brainsmoke/usb_null/README.md

# USB <-> USB 'null-modem' (but electrically isolated) [UNTESTED]

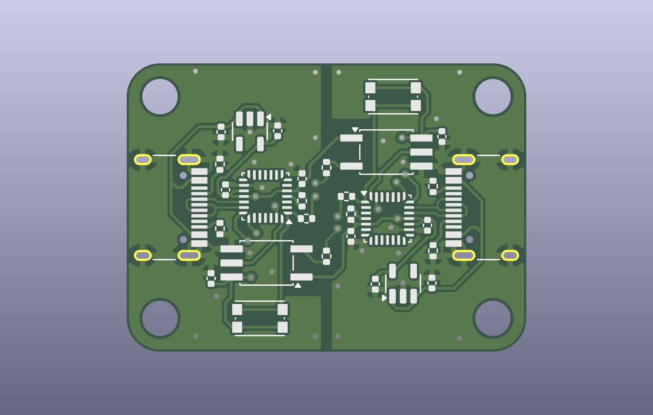
[picture p1: img/usb_null.png]


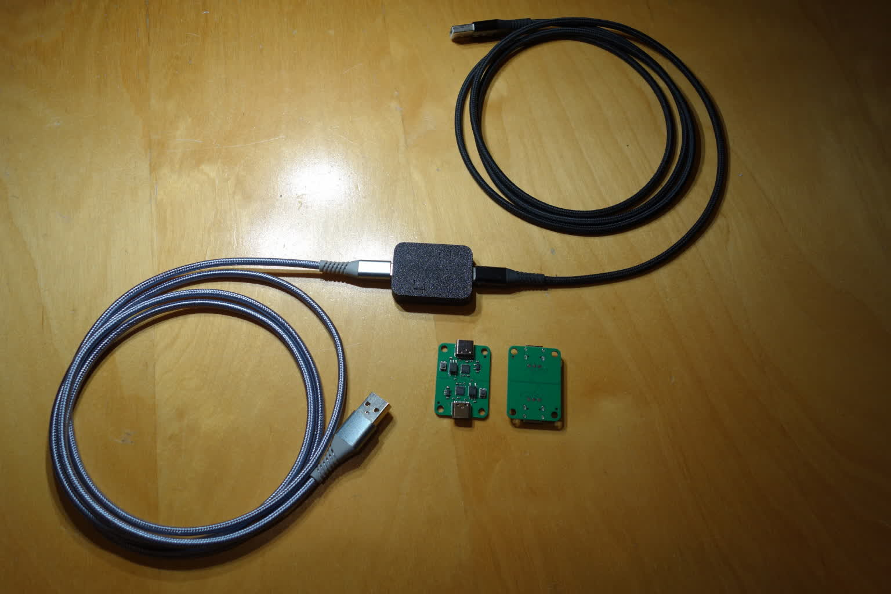
[picture p2: img/usb_null.jpg]


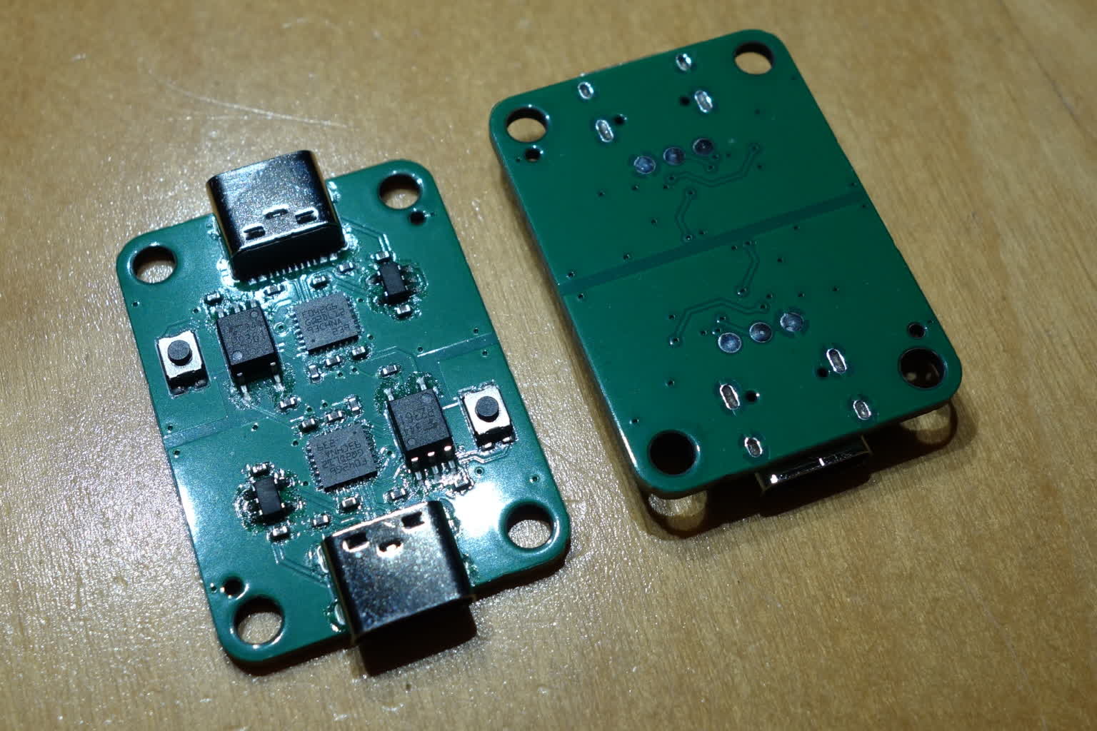
[picture p3: img/usb_null_closeup.jpg]
