brainsmoke/usb_null/build/usb_null/case.stl

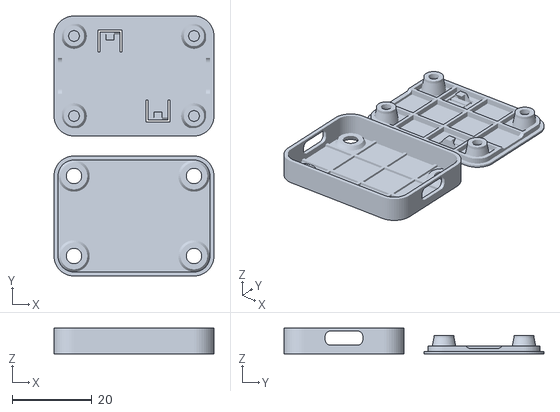
[picture p4: CAD file, 2025-11-07]
build/usb_null/case.stl
40.0 x 65.0 x 6.40
