brainsmoke/usb_null/(list of files, cad)

Other CAD files:
case/case_bottom.scad
case/case_top.scad
case/case_top_plain.scad
case/graft.scad
case/grid.scad
case/jst.scad
case/usb.scad
