brainsmoke/usb_null/pcb/usb_null/project.kicad_pcb

## KiCad design pcb/usb_null/project.kicad_pcb (2025-11-06)

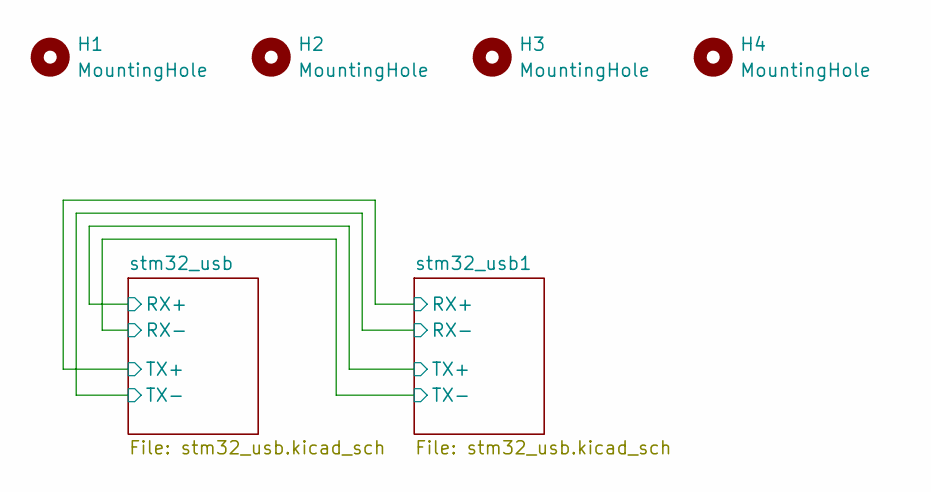
[picture p5: schematic project.kicad_sch]

Parts:
H1, H2, H3, H4: MountingHole; MountingHole_3.2mm_M3_DIN965

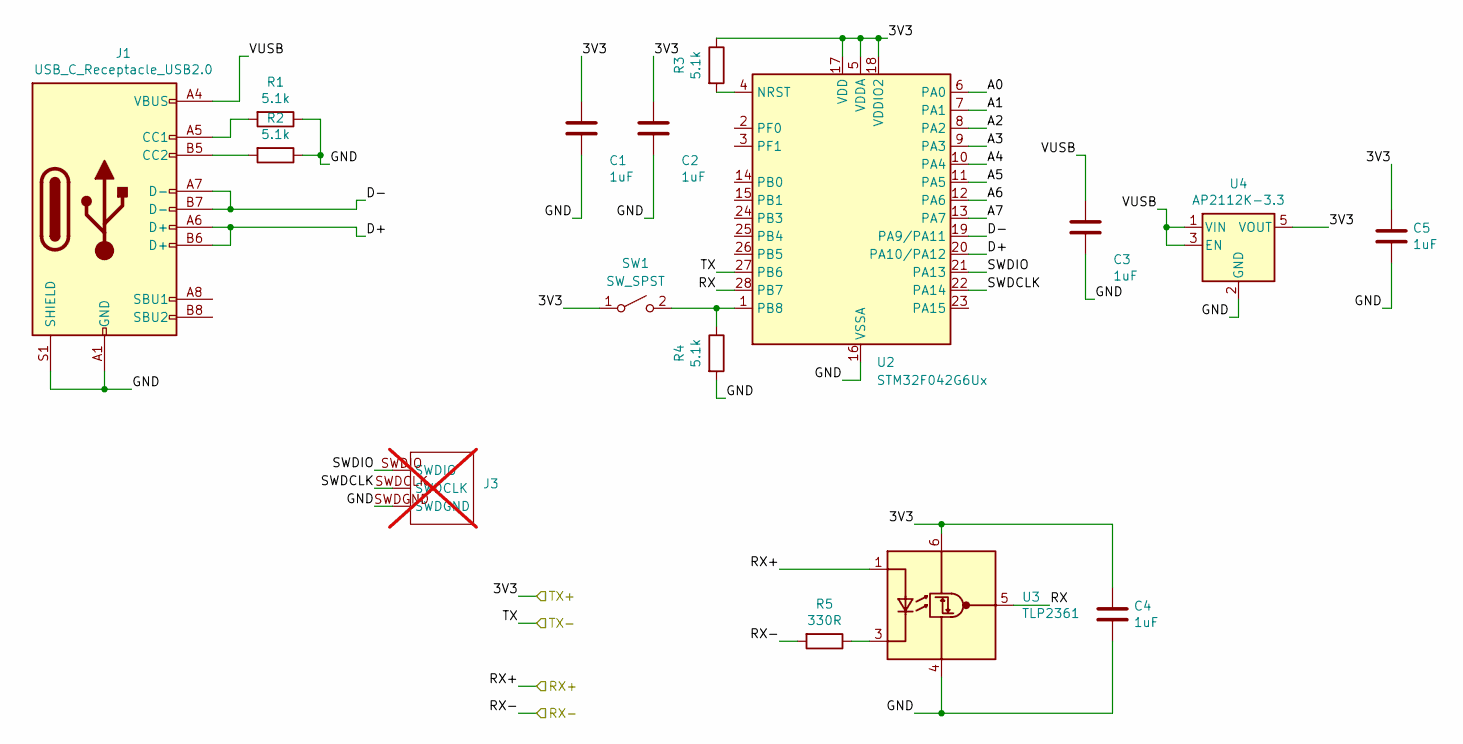
[picture p6: schematic stm32_usb.kicad_sch]

Parts:
C1, C2, C3, C4, C5: 1uF; C_0402_1005Metric; LCSC C52923
J1: USB_C_Receptacle_USB2.0; USB_C_Receptacle_HRO_TYPE-C-31-M-12; LCSC C165948
J3: SWDHeader; not fitted
R1, R2, R3, R4: 5.1k; R_0402_1005Metric; LCSC C25905
R5: 330R; R_0402_1005Metric; LCSC C25104
SW1: SW_SPST; SW_Push_1P1T_NO_CK_KMR2; LCSC C318893
U2: STM32F042G6Ux; QFN-28_4x4mm_P0.5mm; LCSC C961597
U3: TLP2361; SO-5_4.4x3.6mm_P1.27mm; LCSC C107626
U4: AP2112K-3.3; SOT-23-5; LCSC C51118

Connections:
/stm32_usb/3V3: C1.1, C2.1, C4.1, C5.1, R3.1, SW1.1 (A), U2.5 (VDDA), U2.17 (VDD), U2.18 (VDDIO2), U3.6 (VDD), U4.5 (VOUT); also elsewhere on the board
/stm32_usb/A0: U2.6 (PA0)
/stm32_usb/A1: U2.7 (PA1)
/stm32_usb/A2: U2.8 (PA2)
/stm32_usb/A3: U2.9 (PA3)
/stm32_usb/A4: U2.10 (PA4)
/stm32_usb/A5: U2.11 (PA5)
/stm32_usb/A6: U2.12 (PA6)
/stm32_usb/A7: U2.13 (PA7)
/stm32_usb/D+: J1.A6 (D+), J1.B6 (D+), U2.20 (PA10/PA12)
/stm32_usb/D-: J1.A7 (D-), J1.B7 (D-), U2.19 (PA9/PA11)
/stm32_usb/GND: C1.2, C2.2, C3.2, C4.2, C5.2, J1.A1 (GND), J1.A12 (GND), J1.B1 (GND), J1.B12 (GND), J1.S1 (SHIELD), J3.SWDGND, R1.1, R2.1, R4.2, U2.16 (VSSA), U3.4 (GND), U4.2 (GND)
/stm32_usb/RX: U2.28 (PB7), U3.5 (VO)
/stm32_usb/RX+: U3.1 (A); also elsewhere on the board
/stm32_usb/RX-: R5.2; also elsewhere on the board
/stm32_usb/SWDCLK: J3.SWDCLK, U2.22 (PA14)
/stm32_usb/SWDIO: J3.SWDIO, U2.21 (PA13)
/stm32_usb/TX: U2.27 (PB6); also elsewhere on the board
/stm32_usb/VUSB: C3.1, J1.A4 (VBUS), J1.A9 (VBUS), J1.B4 (VBUS), J1.B9 (VBUS), U4.1 (VIN), U4.3 (EN)
unnamed: J1.A5 (CC1), R1.2
unnamed: J1.B5 (CC2), R2.2
unnamed: R4.1, SW1.2 (B), U2.1 (PB8)
unnamed: R3.2, U2.4 (NRST)
unnamed: R5.1, U3.3 (K)

Parts of its further copies:
C6, C7, C8, C9, C10: 1uF; C_0402_1005Metric; LCSC C52923
J4: USB_C_Receptacle_USB2.0; USB_C_Receptacle_HRO_TYPE-C-31-M-12; LCSC C165948
J6: SWDHeader; not fitted
R6, R7, R8, R9: 5.1k; R_0402_1005Metric; LCSC C25905
R10: 330R; R_0402_1005Metric; LCSC C25104
SW2: SW_SPST; SW_Push_1P1T_NO_CK_KMR2; LCSC C318893
U6: STM32F042G6Ux; QFN-28_4x4mm_P0.5mm; LCSC C961597
U7: TLP2361; SO-5_4.4x3.6mm_P1.27mm; LCSC C107626
U8: AP2112K-3.3; SOT-23-5; LCSC C51118

Connections of its further copies:
/stm32_usb1/A0: U6.6 (PA0)
/stm32_usb1/A1: U6.7 (PA1)
/stm32_usb1/A2: U6.8 (PA2)
/stm32_usb1/A3: U6.9 (PA3)
/stm32_usb1/A4: U6.10 (PA4)
/stm32_usb1/A5: U6.11 (PA5)
/stm32_usb1/A6: U6.12 (PA6)
/stm32_usb1/A7: U6.13 (PA7)
/stm32_usb1/D+: J4.A6 (D+), J4.B6 (D+), U6.20 (PA10/PA12)
/stm32_usb1/D-: J4.A7 (D-), J4.B7 (D-), U6.19 (PA9/PA11)
/stm32_usb1/GND: C6.2, C7.2, C8.2, C9.2, C10.2, J4.A1 (GND), J4.A12 (GND), J4.B1 (GND), J4.B12 (GND), J4.S1 (SHIELD), J6.SWDGND, R6.1, R7.1, R9.2, U6.16 (VSSA), U7.4 (GND), U8.2 (GND)
/stm32_usb1/RX: U6.28 (PB7), U7.5 (VO)
/stm32_usb1/SWDCLK: J6.SWDCLK, U6.22 (PA14)
/stm32_usb1/SWDIO: J6.SWDIO, U6.21 (PA13)
/stm32_usb1/VUSB: C8.1, J4.A4 (VBUS), J4.A9 (VBUS), J4.B4 (VBUS), J4.B9 (VBUS), U8.1 (VIN), U8.3 (EN)
/stm32_usb/3V3: U7.1 (A); also elsewhere on the board
/stm32_usb/RX+: C6.1, C7.1, C9.1, C10.1, R8.1, SW2.1 (A), U6.5 (VDDA), U6.17 (VDD), U6.18 (VDDIO2), U7.6 (VDD), U8.5 (VOUT); also elsewhere on the board
/stm32_usb/RX-: U6.27 (PB6); also elsewhere on the board
/stm32_usb/TX: R10.2; also elsewhere on the board
unnamed: J4.A5 (CC1), R6.2
unnamed: J4.B5 (CC2), R7.2
unnamed: R9.1, SW2.2 (B), U6.1 (PB8)
unnamed: R8.2, U6.4 (NRST)
unnamed: R10.1, U7.3 (K)

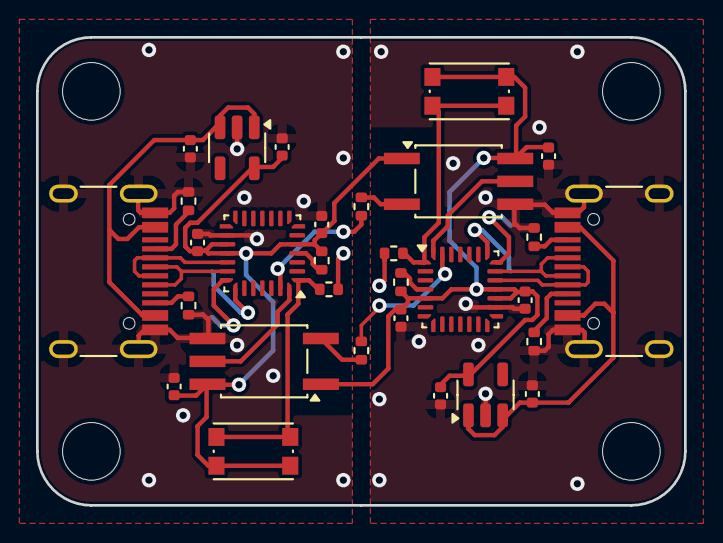
[picture p7: board project.kicad_pcb from above]

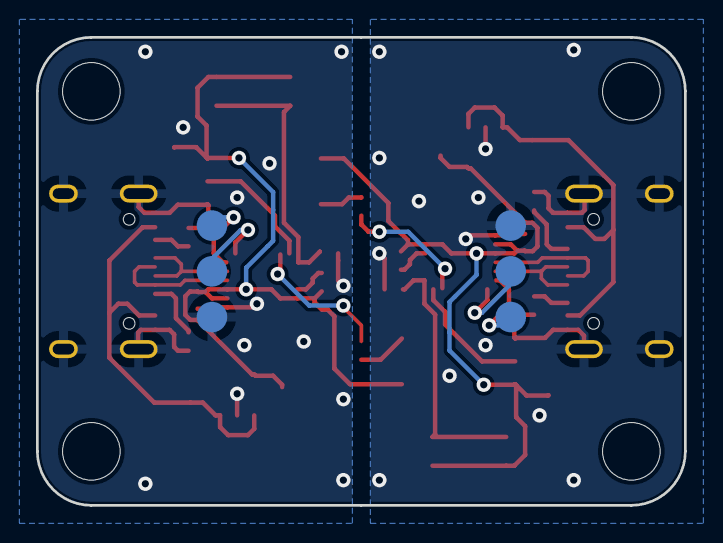
[picture p8: board project.kicad_pcb from below]

Board: 2 copper layers, 36.0 x 26.0 mm, 36 parts (2 on the bottom side), 28 nets.
