brainsmoke/usb_null/(commit log)

2025-11-06 isolated usb<->usb device
    [bomfile_jlc.csv, posfile_jlc.csv, project.kicad_pcb, project.kicad_sch, stm32_usb.kicad_sch]
2025-11-06 fix rotations in posfile
    [posfile_jlc.csv]
2025-11-07 add case [also untested]
    [button.scad, case.scad, case.stl, case_base.scad, case_bottom.scad, case_top.scad, case_top_plain.scad, graft.scad]
2025-11-21 fix individual top / bottom files
    [case_bottom.scad, case_top.scad]
